Pmitrega/Linefollower_V2/README.md

# Linefollower_V2
Continuation of Linefollower project on new board
