Pmitrega/Linefollower_V2/board/BOARD_v4.1/BOARD_v4.kicad_pcb

## KiCad design board/BOARD_v4.1/BOARD_v4.kicad_pcb (2023-03-24)

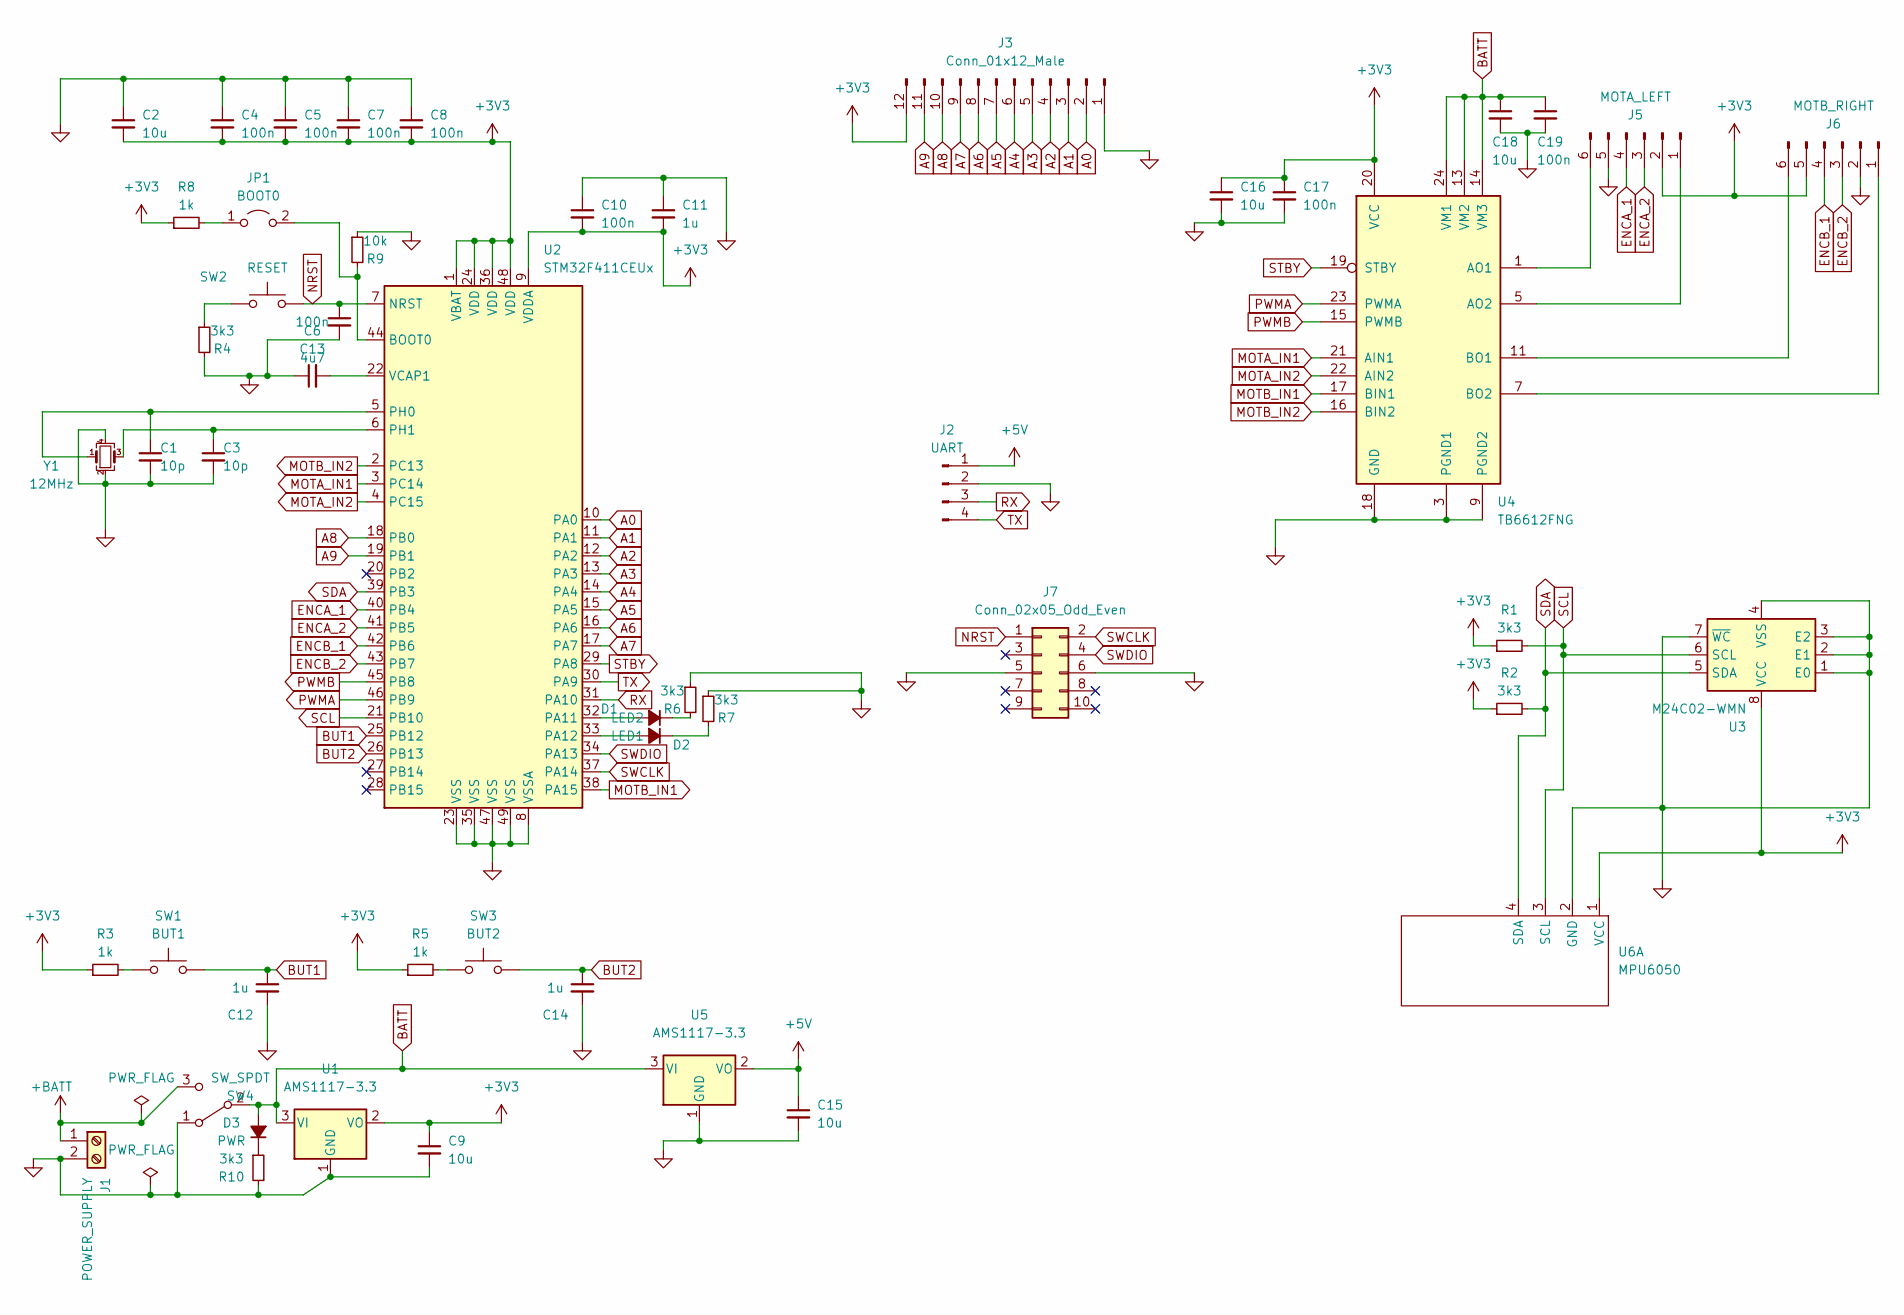
[picture p2: schematic BOARD_v4.kicad_sch]

Parts:
C1, C3: 10p; C_0603_1608Metric_Pad1.08x0.95mm_HandSolder
C2, C9, C15, C16, C18: 10u; C_0805_2012Metric_Pad1.18x1.45mm_HandSolder
C4, C5, C7, C8, C10, C13, C17, C19: 100n; C_0603_1608Metric_Pad1.08x0.95mm_HandSolder
C6: 4u7; C_0603_1608Metric_Pad1.08x0.95mm_HandSolder
C11, C12, C14: 1u; C_0603_1608Metric_Pad1.08x0.95mm_HandSolder
D1: LED2; LED_0805_2012Metric_Pad1.15x1.40mm_HandSolder
D2: LED1; LED_0805_2012Metric_Pad1.15x1.40mm_HandSolder
D3: PWR; LED_0805_2012Metric_Pad1.15x1.40mm_HandSolder
J1: POWER_SUPPLY; TerminalBlock_4Ucon_1x02_P3.50mm_Horizontal
J2: UART; PinSocket_1x04_P2.54mm_Vertical
J3: Conn_01x12_Male; Hirose_FH12-12S-0.5SH_1x12-1MP_P0.50mm_Horizontal
J5: MOTA_LEFT; PinSocket_1x06_P2.54mm_Vertical
J6: MOTB_RIGHT; PinSocket_1x06_P2.54mm_Vertical
J7: Conn_02x05_Odd_Even; IDC-Header_2x05_P2.54mm_Vertical
JP1: BOOT0; PinSocket_1x02_P2.54mm_Vertical
R1, R2, R4, R6, R7, R10: 3k3; R_0805_2012Metric_Pad1.20x1.40mm_HandSolder
R3, R5, R8: 1k; R_0805_2012Metric_Pad1.20x1.40mm_HandSolder
R9: 10k; R_0805_2012Metric_Pad1.20x1.40mm_HandSolder
SW1: BUT1; SW_PUSH_6mm
SW2: RESET; SW_PUSH_6mm
SW3: BUT2; SW_PUSH_6mm
SW4: SW_SPDT; SS22T20
U1, U5: AMS1117-3.3; SOT-223-3_TabPin2
U2: STM32F411CEUx; QFN-48-1EP_7x7mm_P0.5mm_EP5.6x5.6mm; LCSC C60420
U3: M24C02-WMN; SOIC-8_3.9x4.9mm_P1.27mm
U4: TB6612FNG; SSOP-24_5.3x8.2mm_P0.65mm; LCSC C88224
U6: MPU6050; MPU6050THT
Y1: 12MHz; Crystal_SMD_3225-4Pin_3.2x2.5mm_HandSoldering

Connections:
+3V3: C2.2, C4.2, C5.2, C7.2, C8.2, C9.1, C10.2, C11.2, C16.1, C17.1, J3.12, J5.2, J6.5, R1.1, R2.1, R3.1, R5.1, R8.1, U1.2 (VO), U2.1 (VBAT), U2.9 (VDDA), U2.24 (VDD), U2.36 (VDD), U2.48 (VDD), U3.8 (VCC), U4.20 (VCC), U6.1 (VCC)
+5V: C15.1, J2.1, U5.2 (VO)
+BATT: J1.1, SW4.3 (C)
A0: J3.2, U2.10 (PA0)
A1: J3.3, U2.11 (PA1)
A2: J3.4, U2.12 (PA2)
A3: J3.5, U2.13 (PA3)
A4: J3.6, U2.14 (PA4)
A5: J3.7, U2.15 (PA5)
A6: J3.8, U2.16 (PA6)
A7: J3.9, U2.17 (PA7)
A8: J3.10, U2.18 (PB0)
A9: J3.11, U2.19 (PB1)
BATT: C18.1, C19.1, D3.2 (A), SW4.2 (B), U1.3 (VI), U4.13 (VM2), U4.14 (VM3), U4.24 (VM1), U5.3 (VI)
BUT1: C12.1, SW1.2, U2.25 (PB12)
BUT2: C14.1, SW3.2, U2.26 (PB13)
ENCA_1: J5.4, U2.40 (PB4)
ENCA_2: J5.3, U2.41 (PB5)
ENCB_1: J6.4, U2.42 (PB6)
ENCB_2: J6.3, U2.43 (PB7)
GND: C1.2, C2.1, C3.2, C4.1, C5.1, C6.1, C7.1, C8.1, C9.2, C10.1, C11.1, C12.2, C13.2, C14.2, C15.2, C16.2, C17.2, C18.2, C19.2, J1.2, J2.2, J3.1, J5.5, J6.2, J7.5, J7.6, R4.2, R6.1, R7.1, R9.1, R10.2, SW4.1 (A), U1.1 (GND), U2.8 (VSSA), U2.23 (VSS), U2.35 (VSS), U2.47 (VSS), U2.49 (VSS), U3.1 (E0), U3.2 (E1), U3.3 (E2), U3.4 (VSS), U3.7 (~WC), U4.3 (PGND1), U4.4 (PGND1), U4.9 (PGND2), U4.10 (PGND2), U4.18 (GND), U5.1 (GND), U6.2 (GND), Y1.2, Y1.4
MOTA_IN1: U2.3 (PC14), U4.21 (AIN1)
MOTA_IN2: U2.4 (PC15), U4.22 (AIN2)
MOTB_IN1: U2.38 (PA15), U4.17 (BIN1)
MOTB_IN2: U2.2 (PC13), U4.16 (BIN2)
NRST: C13.1, J7.1, SW2.2, U2.7 (NRST)
unnamed: C1.1, U2.5 (PH0), Y1.1
unnamed: C3.1, U2.6 (PH1), Y1.3
unnamed: C6.2, U2.22 (VCAP1)
unnamed: D1.1 (K), R6.2
unnamed: D1.2 (A), U2.32 (PA11)
unnamed: D2.1 (K), R7.2
unnamed: D2.2 (A), U2.33 (PA12)
unnamed: D3.1 (K), R10.1
unnamed: J5.1, U4.5 (AO2), U4.6 (AO2)
unnamed: J5.6, U4.1 (AO1), U4.2 (AO1)
unnamed: J6.1, U4.7 (BO2), U4.8 (BO2)
unnamed: J6.6, U4.11 (BO1), U4.12 (BO1)
unnamed: JP1.1 (A), R8.2
unnamed: JP1.2 (B), R9.2, U2.44 (BOOT0)
unnamed: R3.2, SW1.1
unnamed: R4.1, SW2.1
unnamed: R5.2, SW3.1
PWMA: U2.46 (PB9), U4.23 (PWMA)
PWMB: U2.45 (PB8), U4.15 (PWMB)
RX: J2.3, U2.31 (PA10)
SCL: R1.2, U2.21 (PB10), U3.6 (SCL), U6.3 (SCL)
SDA: R2.2, U2.39 (PB3), U3.5 (SDA), U6.4 (SDA)
STBY: U2.29 (PA8), U4.19 (STBY)
SWCLK: J7.2, U2.37 (PA14)
SWDIO: J7.4, U2.34 (PA13)
TX: J2.4, U2.30 (PA9)

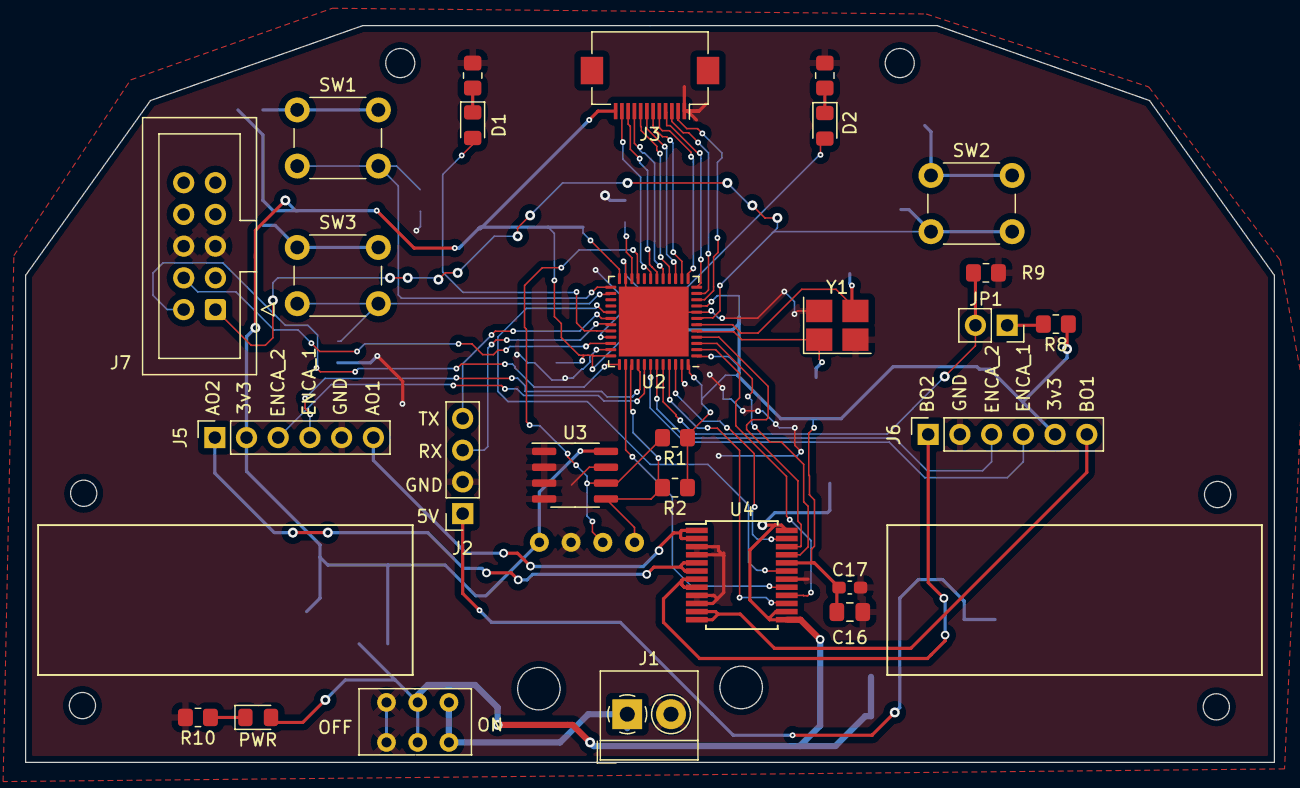
[picture p3: board BOARD_v4.kicad_pcb from above]

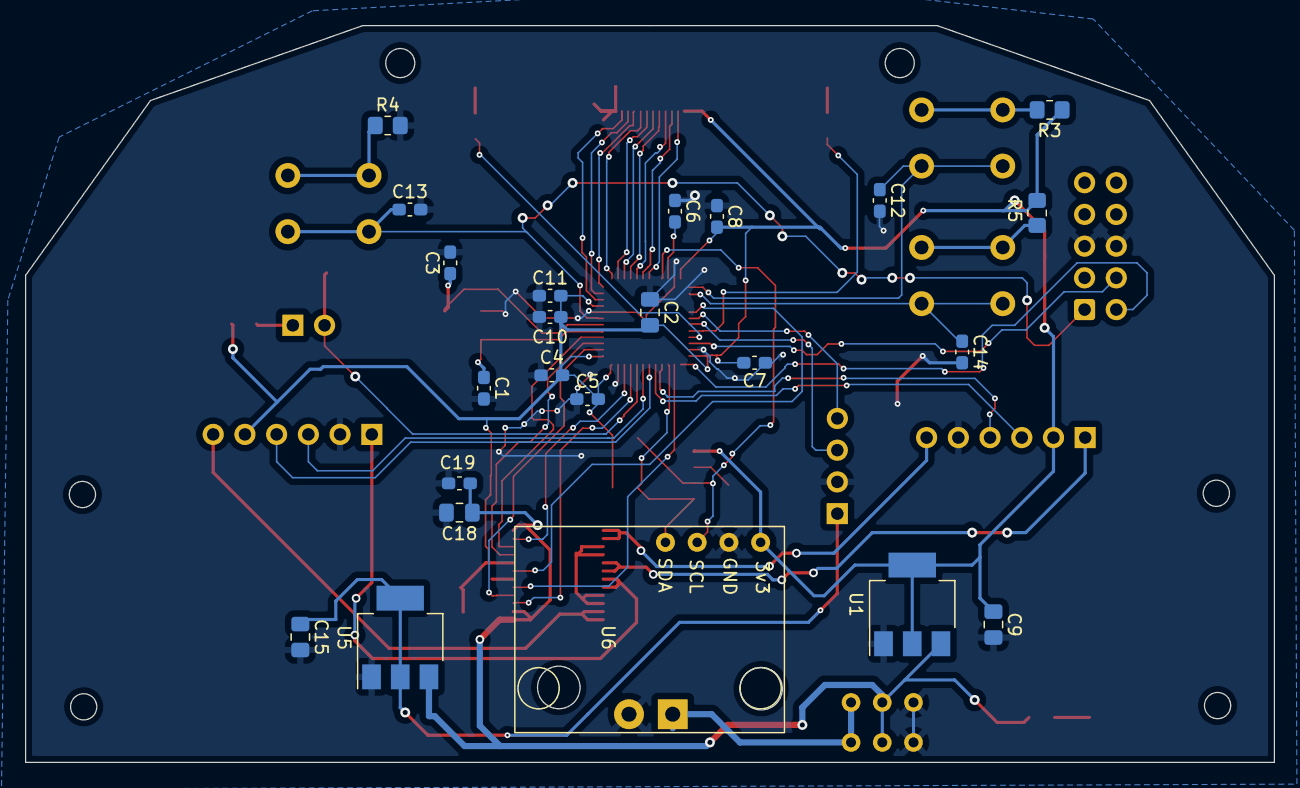
[picture p4: board BOARD_v4.kicad_pcb from below]

Board: 2 copper layers, 100.0 x 59.0 mm, 50 parts (23 on the bottom side), 52 nets.
