Pmitrega/Linefollower_V2/board/sensors/sensors.kicad_pcb

## KiCad design board/sensors/sensors.kicad_pcb (2023-02-15)

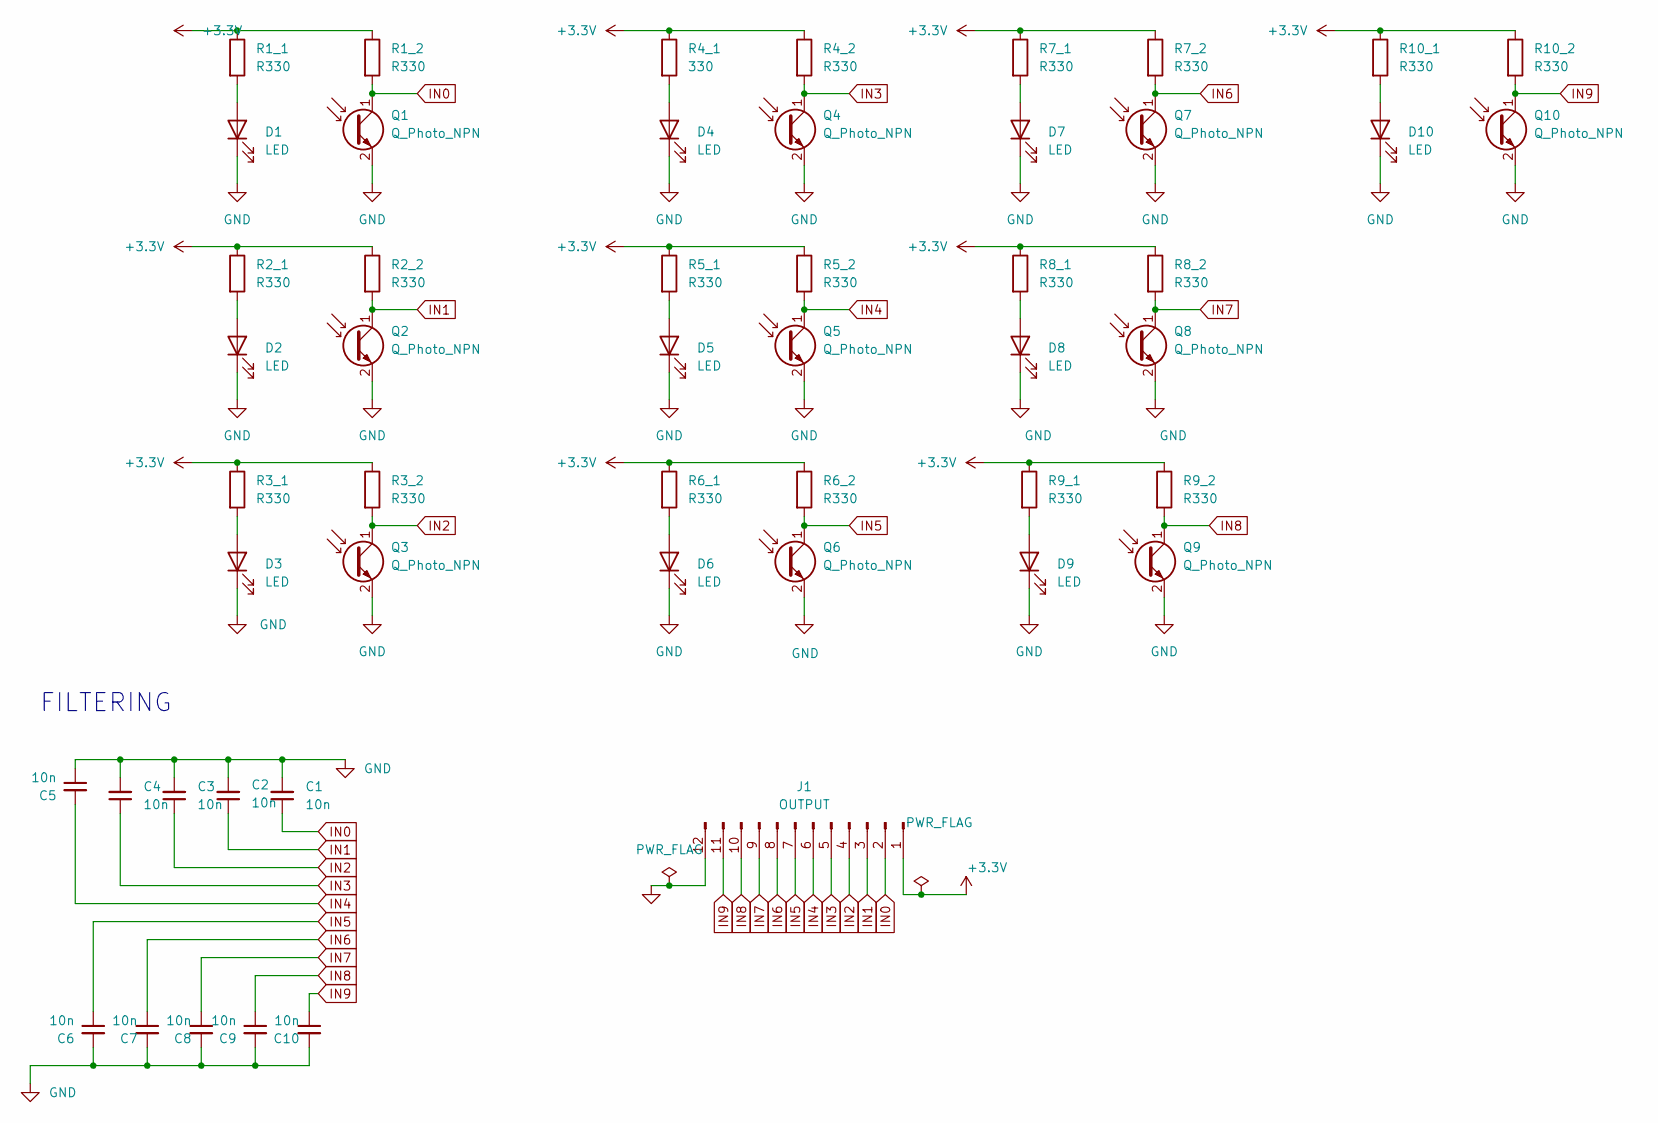
[picture p5: schematic sensors.kicad_sch]

Parts:
C1, C2, C3, C4, C5, C6, C7, C8, C9, C10: 10n; C_0805_2012Metric_Pad1.18x1.45mm_HandSolder
D1, D2, D3, D4, D5, D6, D7, D8, D9, D10: LED; R_0805_2012Metric_Pad1.20x1.40mm_HandSolder
J1: OUTPUT; Hirose_FH12-12S-0.5SH_1x12-1MP_P0.50mm_Horizontal
Q1, Q2, Q3, Q4, Q5, Q6, Q7, Q8, Q9, Q10: Q_Photo_NPN; LED_0805_2012Metric_Pad1.15x1.40mm_HandSolder
R1_1, R1_2, R2_1, R2_2, R3_1, R3_2, R4_2, R5_1, R5_2, R6_1, R6_2, R7_1, R7_2, R8_1, R8_2, R9_1, R9_2, R10_1, R10_2: R330; R_0805_2012Metric_Pad1.20x1.40mm_HandSolder
R4_1: 330; R_0805_2012Metric_Pad1.20x1.40mm_HandSolder

Connections:
+3.3V: J1.1, R1_1.1, R1_2.1, R2_1.1, R2_2.1, R3_1.1, R3_2.1, R4_1.1, R4_2.1, R5_1.1, R5_2.1, R6_1.1, R6_2.1, R7_1.1, R7_2.1, R8_1.1, R8_2.1, R9_1.1, R9_2.1, R10_1.1, R10_2.1
GND: C1.2, C2.2, C3.2, C4.2, C5.1, C6.2, C7.2, C8.2, C9.2, C10.2, D1.1 (K), D2.1 (K), D3.1 (K), D4.1 (K), D5.1 (K), D6.1 (K), D7.1 (K), D8.1 (K), D9.1 (K), D10.1 (K), J1.12, Q1.2 (E), Q2.2 (E), Q3.2 (E), Q4.2 (E), Q5.2 (E), Q6.2 (E), Q7.2 (E), Q8.2 (E), Q9.2 (E), Q10.2 (E)
IN0: C1.1, J1.2, Q1.1 (C), R1_2.2
IN1: C2.1, J1.3, Q2.1 (C), R2_2.2
IN2: C3.1, J1.4, Q3.1 (C), R3_2.2
IN3: C4.1, J1.5, Q4.1 (C), R4_2.2
IN4: C5.2, J1.6, Q5.1 (C), R5_2.2
IN5: C6.1, J1.7, Q6.1 (C), R6_2.2
IN6: C7.1, J1.8, Q7.1 (C), R7_2.2
IN7: C8.1, J1.9, Q8.1 (C), R8_2.2
IN8: C9.1, J1.10, Q9.1 (C), R9_2.2
IN9: C10.1, J1.11, Q10.1 (C), R10_2.2
unnamed: D1.2 (A), R1_1.2
unnamed: D2.2 (A), R2_1.2
unnamed: D3.2 (A), R3_1.2
unnamed: D4.2 (A), R4_1.2
unnamed: D5.2 (A), R5_1.2
unnamed: D6.2 (A), R6_1.2
unnamed: D7.2 (A), R7_1.2
unnamed: D8.2 (A), R8_1.2
unnamed: D9.2 (A), R9_1.2
unnamed: D10.2 (A), R10_1.2

Notes on the sheet:
FILTERING

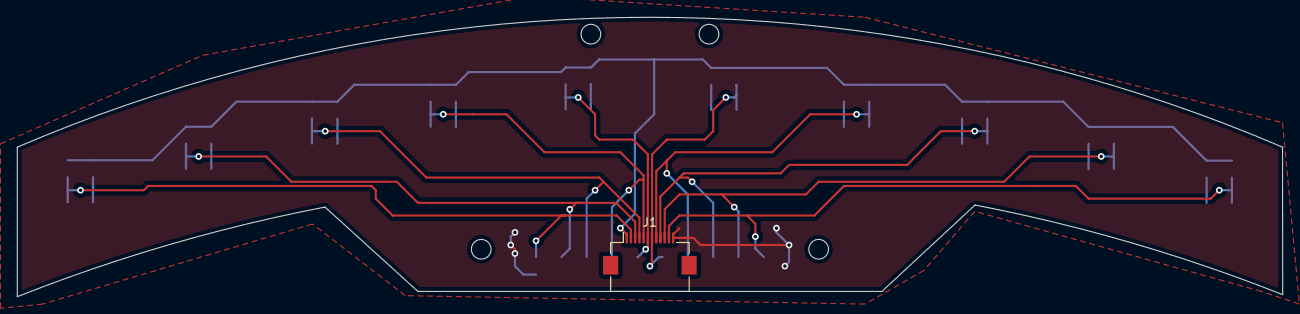
[picture p6: board sensors.kicad_pcb from above]

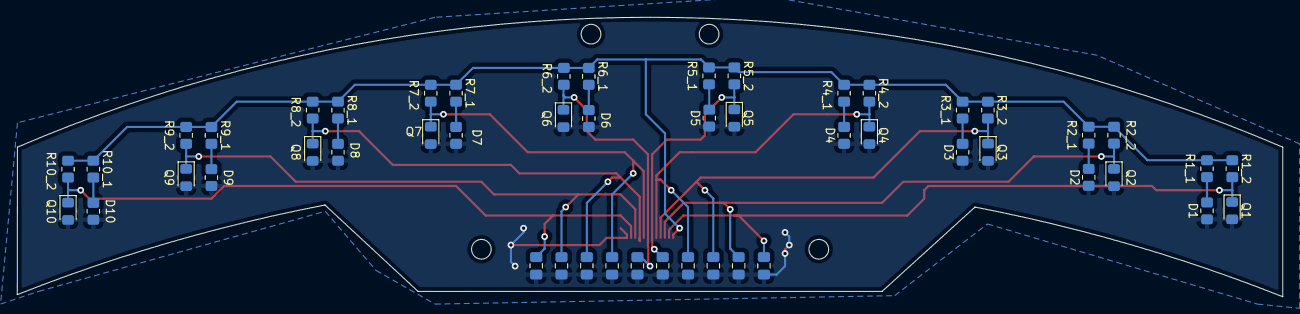
[picture p7: board sensors.kicad_pcb from below]

Board: 2 copper layers, 150.0 x 33.1 mm, 51 parts (50 on the bottom side), 22 nets.
