Pmitrega/Linefollower_V2/Core/Src/main.c

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
/* Includes ------------------------------------------------------------------*/
#include "main.h"

/* USER CODE BEGIN Includes */
#include <stdio.h>
#include "memory.h"
#include "fsm_handler.h"
#include "kalman_filter.h"
#include "sensors.h"
#include "MPU6050.h"
/* USER CODE END Includes */

ADC_HandleTypeDef hadc1;
DMA_HandleTypeDef hdma_adc1;

I2C_HandleTypeDef hi2c2;

TIM_HandleTypeDef htim3;
TIM_HandleTypeDef htim4;
TIM_HandleTypeDef htim5;
TIM_HandleTypeDef htim9;
TIM_HandleTypeDef htim10;
TIM_HandleTypeDef htim11;

UART_HandleTypeDef huart1;

/* USER CODE BEGIN PV */
extern int velocity_left;
extern int velocity_right;
extern int desired_left;
extern int desired_right;
extern uint8_t recieve;
extern uint16_t sensor_readings[10];
int marker = 0;
/* USER CODE END PV */

void SystemClock_Config(void);
static void MX_GPIO_Init(void);
static void MX_DMA_Init(void);
static void MX_ADC1_Init(void);
static void MX_USART1_UART_Init(void);
static void MX_I2C2_Init(void);
static void MX_TIM3_Init(void);
static void MX_TIM4_Init(void);
static void MX_TIM10_Init(void);
static void MX_TIM11_Init(void);
static void MX_TIM9_Init(void);
static void MX_TIM5_Init(void);
/* USER CODE BEGIN 0 */
// #ifdef __GNUC__
// #define PUTCHAR_PROTOTYPE int __io_putchar(int ch)
// #else
// #define PUTCHAR_PROTOTYPE int fputc(int ch, FILE *f)
// #endif

// PUTCHAR_PROTOTYPE
// {
//   HAL_UART_Transmit(&huart1, (uint8_t *)&ch, 1, HAL_MAX_DELAY);
//   return ch;
// }
float angle;
void HAL_TIM_PeriodElapsedCallback(TIM_HandleTypeDef *htim)
{
  static uint32_t counter = 0;
  /* Prevent unused argument(s) compilation warning */
  if(htim == &htim5){
    velocity_left = (int)update_kalman_left((float)ENCODER_LEFT);
    velocity_right = (int)update_kalman_right((float)ENCODER_RIGHT);
    angle = estimate_angle();
  }
  if(htim == &htim9){

    pid_global();
    counter+=1;
  }
}


/* USER CODE END 0 */

/**
  * @brief  The application entry point.
  * @retval int
  */
int main(void)
{
  /* MCU Configuration--------------------------------------------------------*/

  /* Reset of all peripherals, Initializes the Flash interface and the Systick. */
  HAL_Init();

  /* Configure the system clock */
  SystemClock_Config();

  /* Initialize all configured peripherals */
  MX_GPIO_Init();
  MX_DMA_Init();
  MX_ADC1_Init();
  MX_USART1_UART_Init();
  MX_I2C2_Init();
  MX_TIM3_Init();
  MX_TIM4_Init();
  MX_TIM10_Init();
  MX_TIM11_Init();
  MX_TIM9_Init();
  MX_TIM5_Init();
  /* USER CODE BEGIN 2 */
  char buff[80];
  int l;
  ENCODER_LEFT = 32000;
  ENCODER_RIGHT = 32000;

  HAL_TIM_PWM_Start(&htim10, TIM_CHANNEL_1);
  HAL_TIM_PWM_Start(&htim11, TIM_CHANNEL_1);
  HAL_TIM_Encoder_Start(&htim3, TIM_CHANNEL_ALL);
  HAL_TIM_Encoder_Start(&htim4, TIM_CHANNEL_ALL);
  HAL_TIM_Base_Start_IT(&htim9);
  HAL_TIM_Base_Start_IT(&htim5);
  HAL_GPIO_WritePin(STBY_GPIO_Port, STBY_Pin,1);
  HAL_ADC_Start_DMA(&hadc1,sensor_readings, 10);
  HAL_UART_Receive_IT(&huart1, &recieve, 1);
  HAL_Delay(10);
  update_counter();
  HAL_Delay(10);
  read_from_eeprom();
  all_handler(0,0);
  while(!HAL_GPIO_ReadPin(BUT1_GPIO_Port, BUT1_Pin)){
    HAL_GPIO_TogglePin(LED1_GPIO_Port, LED1_Pin);
    HAL_Delay(200); 
  }
  HAL_Delay(300);
  marker = 5000;
  desired_left = 2000;
  desired_right = 2000;
  uint8_t read_data;
  uint8_t reading;
  uint8_t uart_buffer[50];
  MPU6050_SETTINGS MPU6050_sett;
  MPU6050_default_setting(&MPU6050_sett);
  MPU6050_sett.ACC_RANGE = MPU6050_ACC_2G;
  MPU6050_sett.GYRO_RANGE = MPU6050_GYRO_1000DPS;
  MPU6050_sett.DLPF = MPU6050_DLPF_5;
  int accX;
  int accY;
  int accZ;
  HAL_Delay(30);
  MPU6050_wakeup();
  HAL_Delay(5);
  MPU6050_set_config(&MPU6050_sett);
  /* USER CODE END 2 */

  /* Infinite loop */
  /* USER CODE BEGIN WHILE */
  while (1)
  {
    HAL_Delay(10);
    accX = MPU_get_gyro(X);
    accY = MPU_get_gyro(Y);
    accZ = MPU_get_gyro(Z);
    l = sprintf(uart_buffer,"%d %d %d\n", accX, accY, accZ);
    HAL_UART_Transmit(&huart1,uart_buffer, l, 1000);
    // l = sprintf(buff, "vel;%d %d \n", velocity_left, velocity_right);
    // HAL_UART_Transmit(&huart1, buff, l,100);
    /* USER CODE END WHILE */

    /* USER CODE BEGIN 3 */
  }
  /* USER CODE END 3 */
}

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
