Pmitrega/Linefollower_V2/Core/Inc/main.h

#define B_IN2_Pin GPIO_PIN_13
#define B_IN2_GPIO_Port GPIOC
#define A_IN1_Pin GPIO_PIN_14
#define A_IN1_GPIO_Port GPIOC
#define A_IN2_Pin GPIO_PIN_15
#define A_IN2_GPIO_Port GPIOC
#define BUT1_Pin GPIO_PIN_12
#define BUT1_GPIO_Port GPIOB
#define BUT2_Pin GPIO_PIN_13
#define BUT2_GPIO_Port GPIOB
#define STBY_Pin GPIO_PIN_8
#define STBY_GPIO_Port GPIOA
#define LED2_Pin GPIO_PIN_11
#define LED2_GPIO_Port GPIOA
#define LED1_Pin GPIO_PIN_12
#define LED1_GPIO_Port GPIOA
#define B_IN1_Pin GPIO_PIN_15
#define B_IN1_GPIO_Port GPIOA
#define ENCA_1_Pin GPIO_PIN_4
#define ENCA_1_GPIO_Port GPIOB
#define ENCA_2_Pin GPIO_PIN_5
#define ENCA_2_GPIO_Port GPIOB
#define ENCB_1_Pin GPIO_PIN_6
#define ENCB_1_GPIO_Port GPIOB
#define ENCB_2_Pin GPIO_PIN_7
#define ENCB_2_GPIO_Port GPIOB
#define PWMB_Pin GPIO_PIN_8
#define PWMB_GPIO_Port GPIOB
#define PWMA_Pin GPIO_PIN_9
#define PWMA_GPIO_Port GPIOB
