Pmitrega/Linefollower_V2/(commit log)

2023-02-15 Motor PID, EEPROM handling
2023-02-15 git ignore update
    [BOARD_v4.kicad_pcb, BOARD_v4.kicad_sch, sensors.kicad_pcb, sensors.kicad_sch]
2023-02-16 sensor with DMA reading, further eeprom handling, started making uart interface
2023-02-22 added manual control and entering sensor values manually, automatic control is not yet done, waiting for mechanical parts
2023-02-22 added board scheme in pdf
2023-02-24 kalman filter added to motors position and velocity!
2023-03-24 estimation of angle and sensor reading filtering with exponential filter
    [BOARD_v4.kicad_pcb, BOARD_v4.kicad_sch]
2023-04-28 created MPU6050 lib with non-interrupt readings, new sensors board was made, line detection code must be updated
